Kampi/6502-Computer/project/Mainboard.kicad_pcb

## KiCad design project/Mainboard.kicad_pcb (2024-10-12)

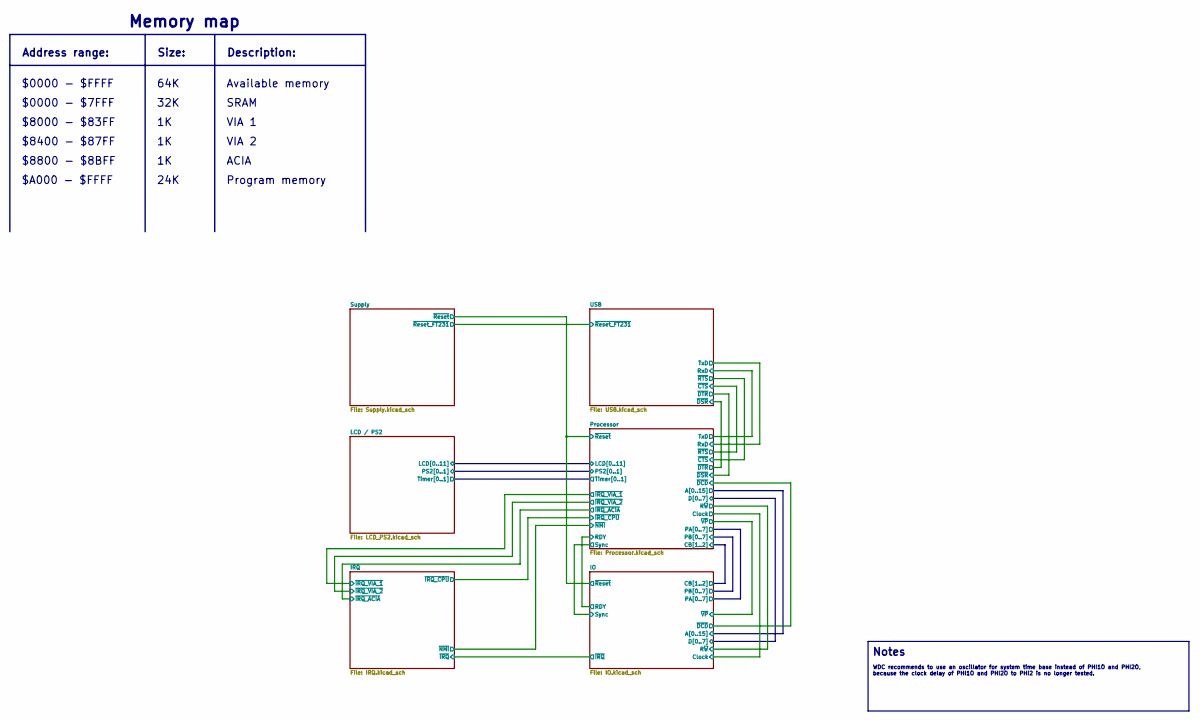
[picture p1: schematic Mainboard.kicad_sch]

Notes on the sheet:
$8000 - $83FF
Notes
$8400 - $87FF
64K
32K
ACIA
WDC recommends to use an oscillator for system time base instead of PHI1O and PHI2O, because the clock delay of PHI1O and PHI2O to PHI2 is no longer tested.
Size:
$8800 - $8BFF
Memory map
Program memory
Available memory
$0000 - $7FFF
SRAM
Address range:
24K
Description:
$0000 - $FFFF
$A000 - $FFFF
VIA 2
VIA 1

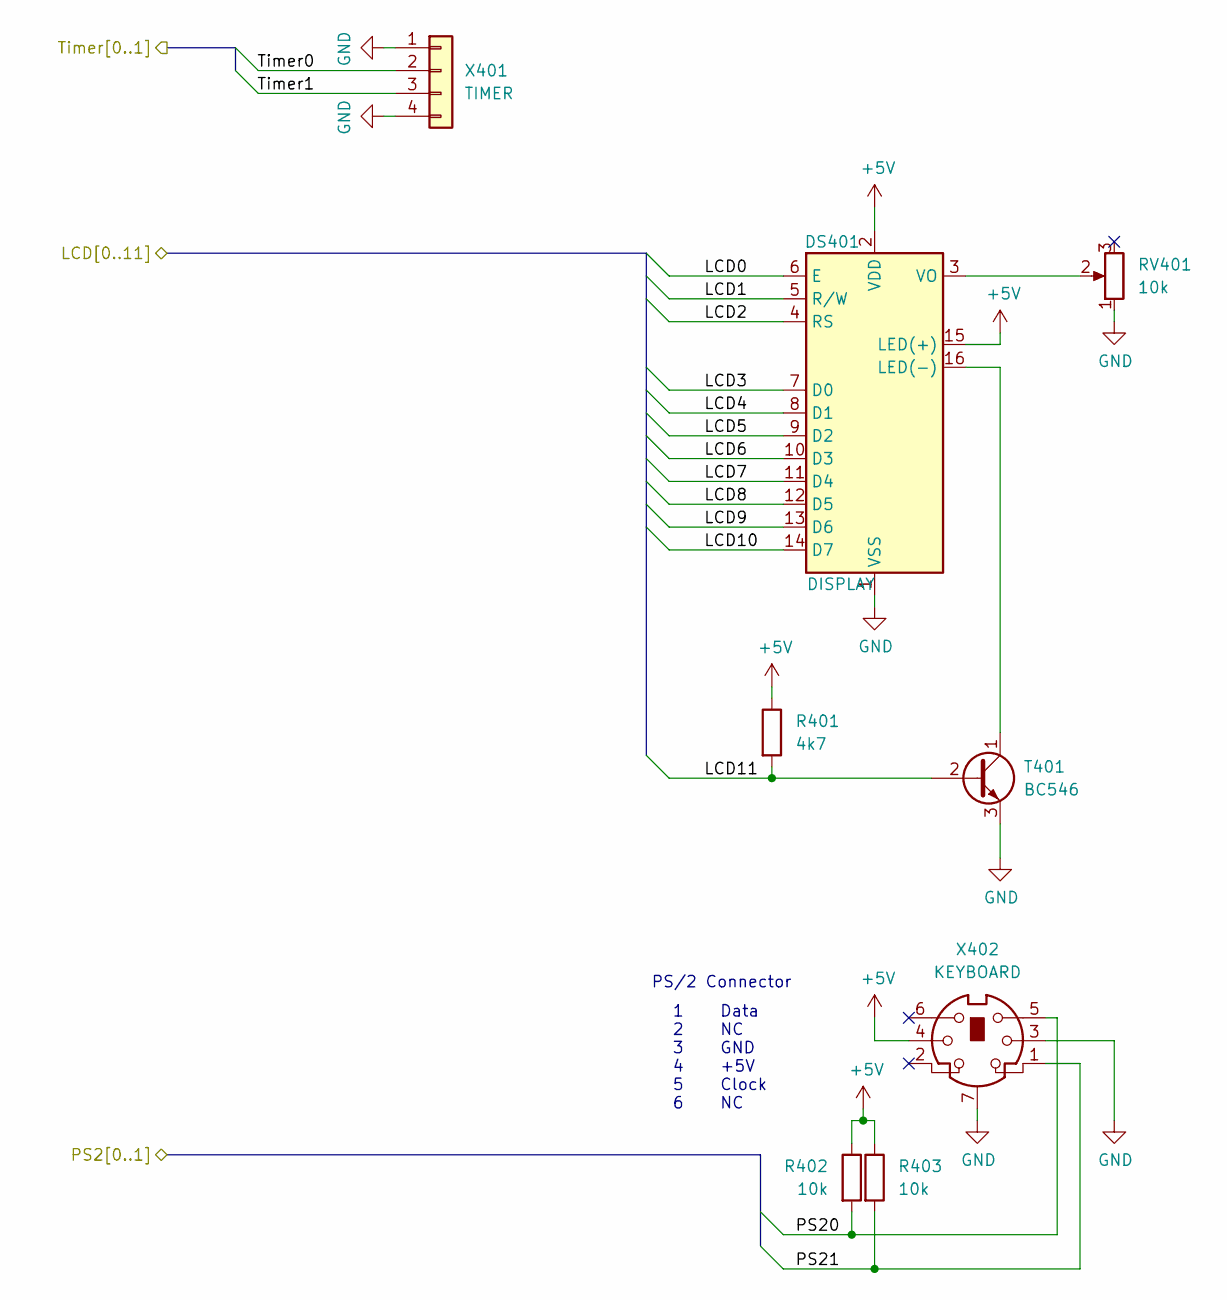
[picture p2: schematic LCD_PS2.kicad_sch, LCD, P2/2 & Timer]

Parts:
DS401: DISPLAY; WC1602A
R401: 4k7; R_Axial_DIN0207_L6.3mm_D2.5mm_P7.62mm_Horizontal
R402, R403: 10k; R_Axial_DIN0207_L6.3mm_D2.5mm_P7.62mm_Horizontal
RV401: 10k; Bourns_3386P_Vertical
T401: BC546; TO-92_Inline
X401: TIMER; PinHeader_1x04_P2.54mm_Vertical
X402: KEYBOARD; Mini-DIN_TE_Female_6Pin_2rows

Connections:
+5V: DS401.2 (VDD), DS401.15 (LED(+)), R401.1, R402.1, R403.1, X402.4; also elsewhere on the board
/LCD / PS2/LCD0: DS401.6 (E); also elsewhere on the board
/LCD / PS2/LCD1: DS401.5 (R/W); also elsewhere on the board
/LCD / PS2/LCD2: DS401.4 (RS); also elsewhere on the board
/LCD / PS2/LCD3: DS401.7 (D0); also elsewhere on the board
/LCD / PS2/LCD4: DS401.8 (D1); also elsewhere on the board
/LCD / PS2/LCD5: DS401.9 (D2); also elsewhere on the board
/LCD / PS2/LCD6: DS401.10 (D3); also elsewhere on the board
/LCD / PS2/LCD7: DS401.11 (D4); also elsewhere on the board
/LCD / PS2/LCD8: DS401.12 (D5); also elsewhere on the board
/LCD / PS2/LCD9: DS401.13 (D6); also elsewhere on the board
/LCD / PS2/LCD10: DS401.14 (D7); also elsewhere on the board
/LCD / PS2/LCD11: R401.2, T401.2 (B); also elsewhere on the board
/LCD / PS2/PS20: R402.2, X402.5; also elsewhere on the board
/LCD / PS2/PS21: R403.2, X402.1; also elsewhere on the board
/LCD / PS2/Timer0: X401.2; also elsewhere on the board
/LCD / PS2/Timer1: X401.3; also elsewhere on the board
GND: DS401.1 (VSS), RV401.1, T401.3 (E), X401.1, X401.4, X402.3, X402.7; also elsewhere on the board
unnamed: DS401.16 (LED(-)), T401.1 (C)
unnamed: DS401.3 (VO), RV401.2

Notes on the sheet:
PS/2 Connector
Data NC GND +5V Clock NC
1 2 3 4 5 6

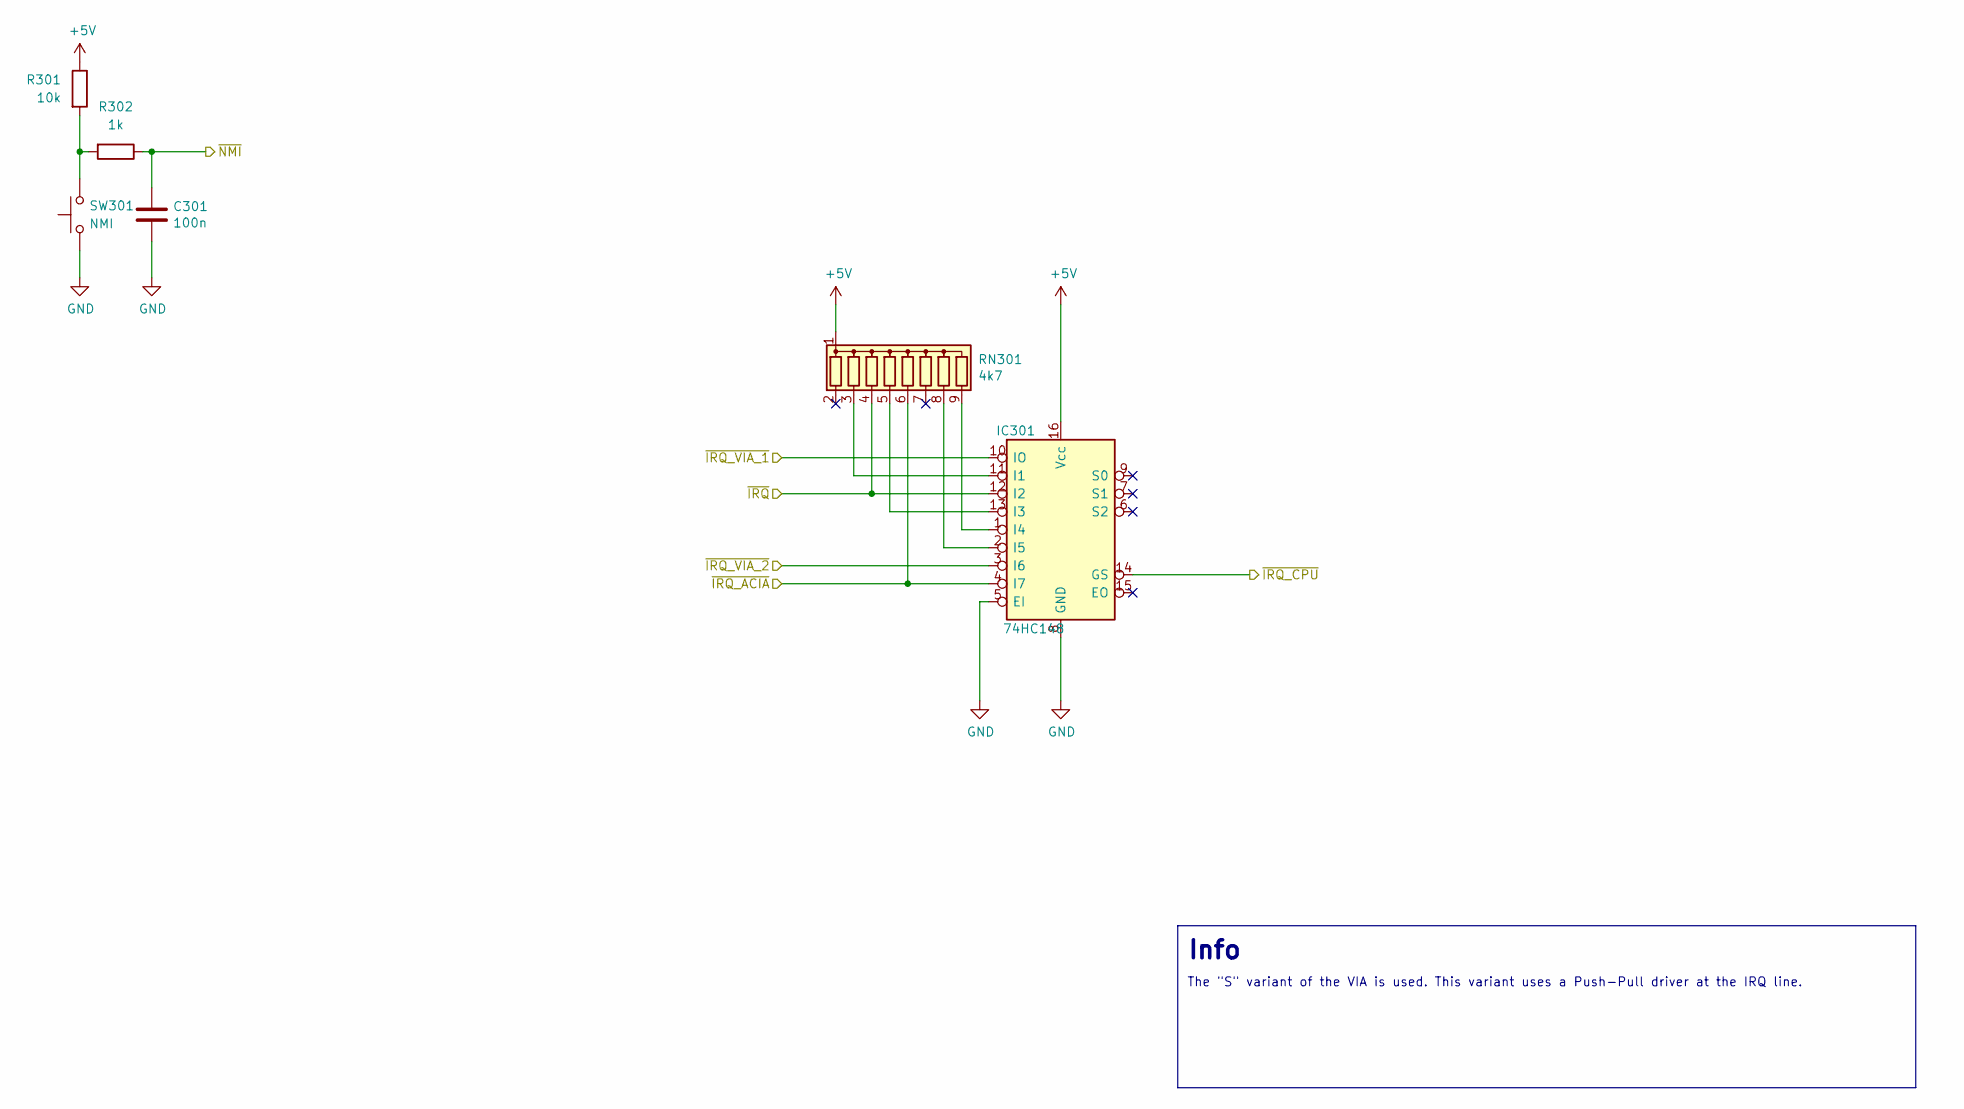
[picture p3: schematic IRQ.kicad_sch, Interrupt logic]

Parts:
C301: 100n; C_Rect_L4.0mm_W2.5mm_P2.50mm
IC301: 74HC148; DIP-16_W7.62mm_LongPads
R301: 10k; R_Axial_DIN0207_L6.3mm_D2.5mm_P7.62mm_Horizontal
R302: 1k; R_Axial_DIN0207_L6.3mm_D2.5mm_P7.62mm_Horizontal
RN301: 4k7; R_Array_SIP9
SW301: NMI; SW_PUSH_6mm_H4.3mm

Connections:
+5V: IC301.16 (Vcc), R301.1, RN301.1 (common); also elsewhere on the board
/IO/~IRQ: IC301.12 (I2), RN301.4 (R3); also elsewhere on the board
/IRQ/~IRQ_ACIA: IC301.4 (I7), RN301.6 (R5); also elsewhere on the board
/IRQ/~IRQ_CPU: IC301.14 (GS); also elsewhere on the board
/IRQ/~IRQ_VIA_1: IC301.10 (IO); also elsewhere on the board
/IRQ/~IRQ_VIA_2: IC301.3 (I6); also elsewhere on the board
/IRQ/~NMI: C301.1, R302.1; also elsewhere on the board
GND: C301.2, IC301.5 (EI), IC301.8 (GND), SW301.1; also elsewhere on the board
unnamed: IC301.11 (I1), RN301.3 (R2)
unnamed: IC301.13 (I3), RN301.5 (R4)
unnamed: IC301.1 (I4), RN301.9 (R8)
unnamed: IC301.2 (I5), RN301.8 (R7)
unnamed: R301.2, R302.2, SW301.2

Notes on the sheet:
Info
The "S" variant of the VIA is used. This variant uses a Push-Pull driver at the IRQ line.

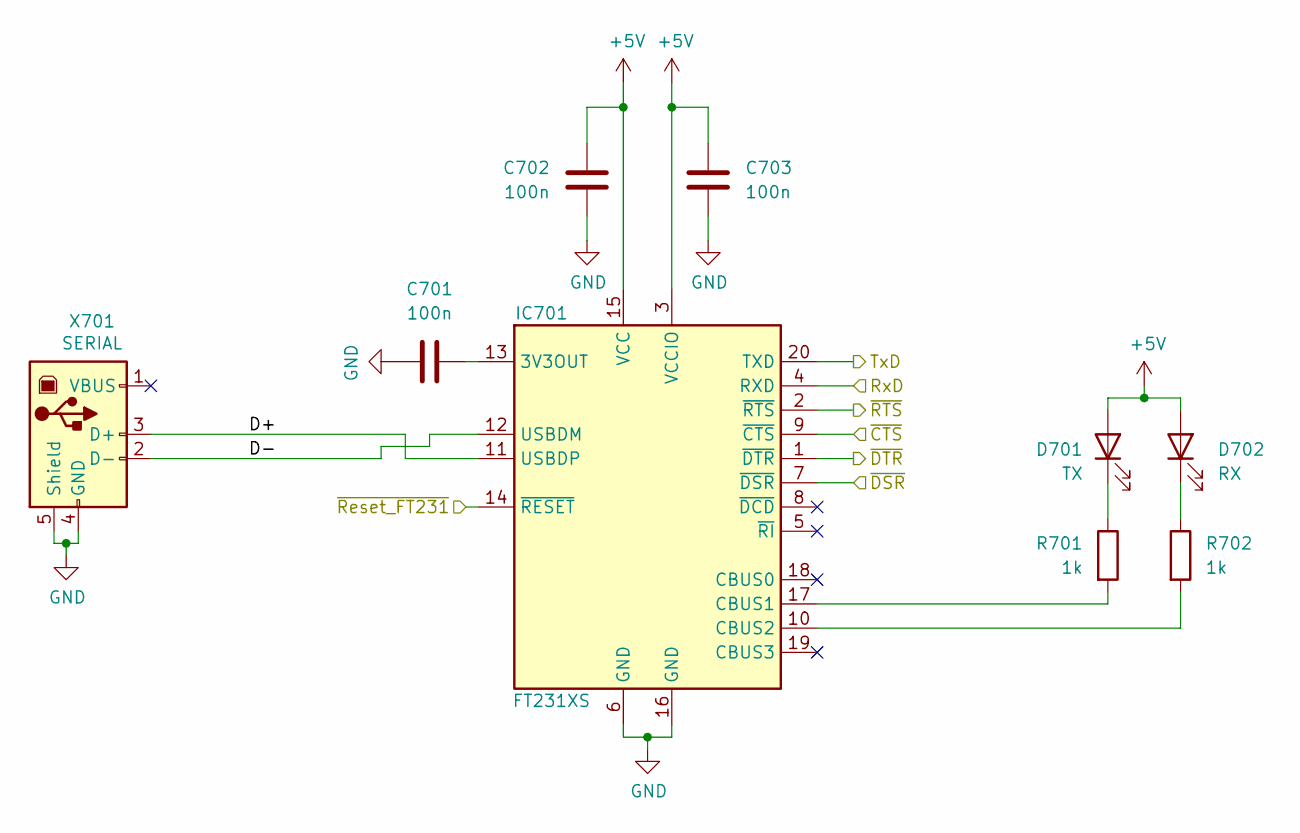
[picture p4: schematic USB.kicad_sch, USB-Serial]

Parts:
C701, C702, C703: 100n; C_0805_2012Metric
D701: TX; LED_0805_2012Metric
D702: RX; LED_0805_2012Metric
IC701: FT231XS; SSOP-20_3.9x8.7mm_P0.635mm
R701, R702: 1k; R_0805_2012Metric
X701: SERIAL; USB-B_TE_2923042_Horizontal

Connections:
+5V: C702.1, C703.1, D701.2 (A), D702.2 (A), IC701.3 (VCCIO), IC701.15 (VCC); also elsewhere on the board
/Processor/RxD: IC701.20 (TXD); also elsewhere on the board
/Processor/TxD: IC701.4 (RXD); also elsewhere on the board
/Processor/~CTS: IC701.2 (~RTS); also elsewhere on the board
/Processor/~DSR: IC701.1 (~DTR); also elsewhere on the board
/Processor/~DTR: IC701.7 (~DSR); also elsewhere on the board
/Processor/~RTS: IC701.9 (~CTS); also elsewhere on the board
/Supply/~Reset_FT231: IC701.14 (~RESET); also elsewhere on the board
/USB/D+: IC701.11 (USBDP), X701.3 (D+)
/USB/D-: IC701.12 (USBDM), X701.2 (D-)
GND: C701.1, C702.2, C703.2, IC701.6 (GND), IC701.16 (GND), X701.4 (GND), X701.5 (Shield); also elsewhere on the board
unnamed: D701.1 (K), R701.1
unnamed: D702.1 (K), R702.1
unnamed: C701.2, IC701.13 (3V3OUT)
unnamed: IC701.17 (CBUS1), R701.2
unnamed: IC701.10 (CBUS2), R702.2

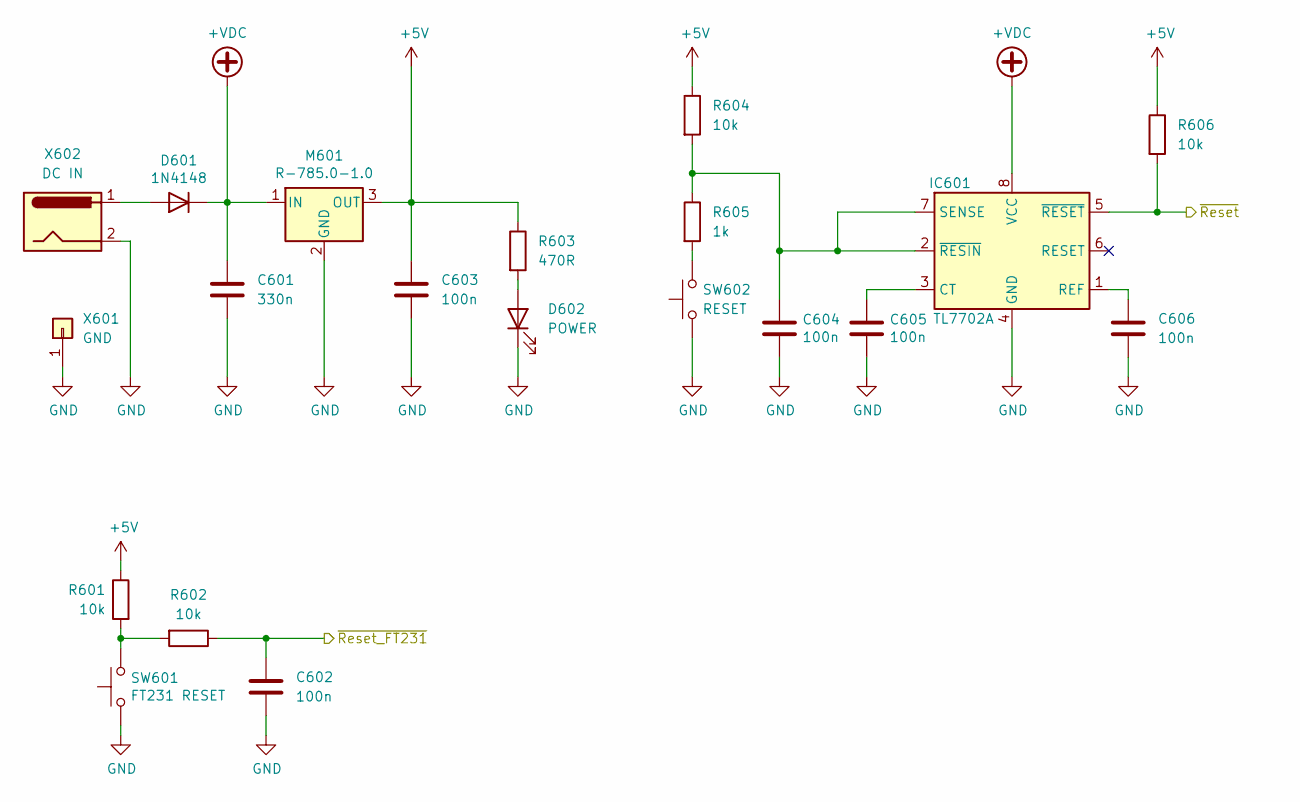
[picture p5: schematic Supply.kicad_sch, Power Supply & Reset]

Parts:
C601: 330n; C_Rect_L4.0mm_W2.5mm_P2.50mm
C602, C603, C604, C605, C606: 100n; C_Rect_L4.0mm_W2.5mm_P2.50mm
D601: 1N4148; D_SOD-123
D602: POWER; LED_D5.0mm
IC601: TL7702A; DIP-8_W7.62mm_LongPads
M601: R-785.0-1.0; Converter_DCDC_RECOM_R-78E-0.5_THT
R601, R602, R604, R606: 10k; R_Axial_DIN0207_L6.3mm_D2.5mm_P7.62mm_Horizontal
R603: 470R; R_Axial_DIN0207_L6.3mm_D2.5mm_P7.62mm_Horizontal
R605: 1k; R_Axial_DIN0207_L6.3mm_D2.5mm_P7.62mm_Horizontal
SW601: FT231 RESET; SW_PUSH_6mm_H4.3mm
SW602: RESET; SW_PUSH_6mm_H4.3mm
X601: GND; PinHeader_1x01_P2.54mm_Vertical
X602: DC IN; BarrelJack_Wuerth_6941xx301002

Connections:
+5V: C603.1, M601.3 (OUT), R601.1, R603.1, R604.1, R606.1; also elsewhere on the board
+VDC: C601.1, D601.1 (K), IC601.8 (VCC), M601.1 (IN)
/IO/~Reset: IC601.5 (~RESET), R606.2; also elsewhere on the board
/Supply/~Reset_FT231: C602.1, R602.1; also elsewhere on the board
GND: C601.2, C602.2, C603.2, C604.2, C605.2, C606.2, D602.1 (K), IC601.4 (GND), M601.2 (GND), SW601.1, SW602.1, X601.1, X602.2; also elsewhere on the board
unnamed: D601.2 (A), X602.1
unnamed: D602.2 (A), R603.2
unnamed: C605.1, IC601.3 (CT)
unnamed: C606.1, IC601.1 (REF)
unnamed: C604.1, IC601.2 (~RESIN), IC601.7 (SENSE), R604.2, R605.1
unnamed: R601.2, R602.2, SW601.2
unnamed: R605.2, SW602.2

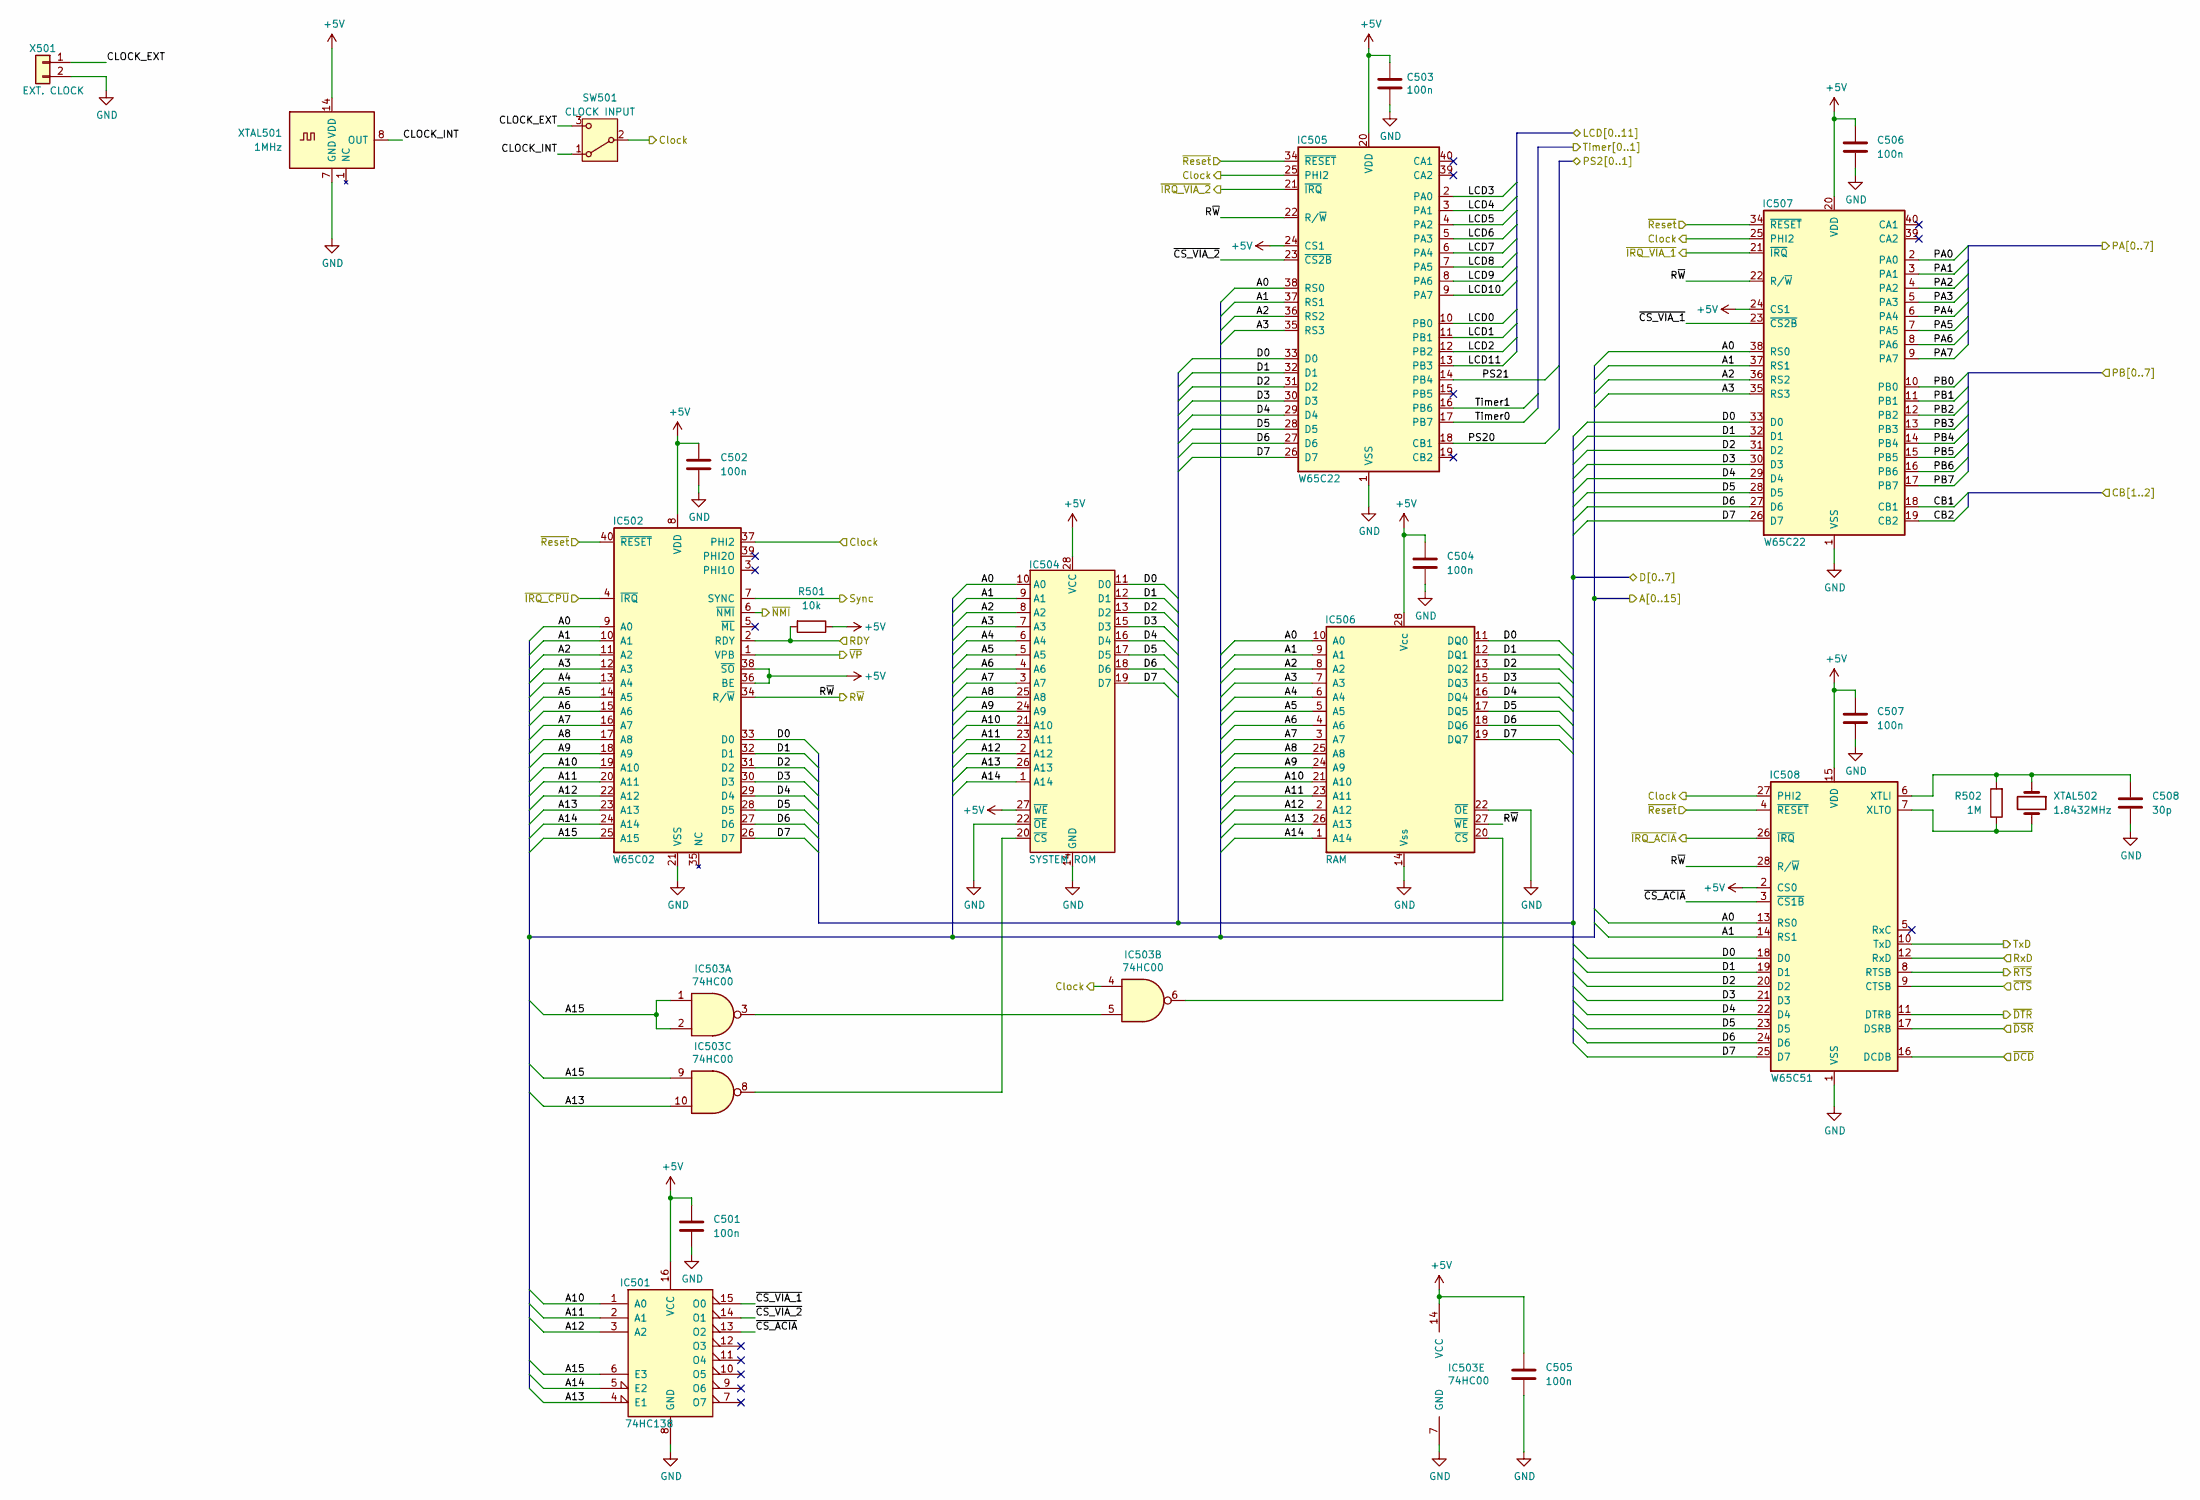
[picture p6: schematic Processor.kicad_sch, Processor system]

Parts:
C501, C502, C503, C504, C505, C506, C507: 100n; C_Rect_L4.0mm_W2.5mm_P2.50mm
C508: 30p; C_Rect_L4.0mm_W2.5mm_P2.50mm
IC501: 74HC138; DIP-16_W7.62mm_LongPads
IC502: W65C02; DIP-40_W15.24mm_LongPads
IC503: 74HC00; DIP-14_W7.62mm_LongPads
IC504: SYSTEM ROM; DIP-28_W15.24mm_LongPads
IC505, IC507: W65C22; DIP-40_W15.24mm_LongPads
IC506: RAM; DIP-28_W15.24mm_LongPads
IC508: W65C51; DIP-28_W15.24mm_LongPads
R501: 10k; R_Axial_DIN0207_L6.3mm_D2.5mm_P7.62mm_Horizontal
R502: 1M; R_Axial_DIN0207_L6.3mm_D2.5mm_P7.62mm_Horizontal
SW501: CLOCK INPUT; SW_E-Switch_EG1271_DPDT
X501: EXT. CLOCK; SMA_Amphenol_901-144_Vertical
XTAL501: 1MHz; Oscillator_DIP-14
XTAL502: 1.8432MHz; Crystal_HC49-U_Vertical

Connections:
+5V: C501.1, C502.1, C503.1, C504.1, C505.1, C506.1, C507.1, IC501.16 (VCC), IC502.8 (VDD), IC502.36 (BE), IC502.38 (~SO), IC503.14 (VCC), IC504.27 (~WE), IC504.28 (VCC), IC505.20 (VDD), IC505.24 (CS1), IC506.28 (Vcc), IC507.20 (VDD), IC507.24 (CS1), IC508.2 (CS0), IC508.15 (VDD), R501.1, XTAL501.14 (VDD); also elsewhere on the board
/IO/A0: IC502.9 (A0), IC504.10 (A0), IC505.38 (RS0), IC506.10 (A0), IC507.38 (RS0), IC508.13 (RS0); also elsewhere on the board
/IO/A1: IC502.10 (A1), IC504.9 (A1), IC505.37 (RS1), IC506.9 (A1), IC507.37 (RS1), IC508.14 (RS1); also elsewhere on the board
/IO/A2: IC502.11 (A2), IC504.8 (A2), IC505.36 (RS2), IC506.8 (A2), IC507.36 (RS2); also elsewhere on the board
/IO/A3: IC502.12 (A3), IC504.7 (A3), IC505.35 (RS3), IC506.7 (A3), IC507.35 (RS3); also elsewhere on the board
/IO/A4: IC502.13 (A4), IC504.6 (A4), IC506.6 (A4); also elsewhere on the board
/IO/A5: IC502.14 (A5), IC504.5 (A5), IC506.5 (A5); also elsewhere on the board
/IO/A6: IC502.15 (A6), IC504.4 (A6), IC506.4 (A6); also elsewhere on the board
/IO/A7: IC502.16 (A7), IC504.3 (A7), IC506.3 (A7); also elsewhere on the board
/IO/A8: IC502.17 (A8), IC504.25 (A8), IC506.25 (A8); also elsewhere on the board
/IO/A9: IC502.18 (A9), IC504.24 (A9), IC506.24 (A9); also elsewhere on the board
/IO/A10: IC501.1 (A0), IC502.19 (A10), IC504.21 (A10), IC506.21 (A10); also elsewhere on the board
/IO/A11: IC501.2 (A1), IC502.20 (A11), IC504.23 (A11), IC506.23 (A11); also elsewhere on the board
/IO/A12: IC501.3 (A2), IC502.22 (A12), IC504.2 (A12), IC506.2 (A12); also elsewhere on the board
/IO/A13: IC501.4 (E1), IC502.23 (A13), IC503.10, IC504.26 (A13), IC506.26 (A13); also elsewhere on the board
/IO/A14: IC501.5 (E2), IC502.24 (A14), IC504.1 (A14), IC506.1 (A14); also elsewhere on the board
/IO/A15: IC501.6 (E3), IC502.25 (A15), IC503.1, IC503.2, IC503.9; also elsewhere on the board
/IO/CB1: IC507.18 (CB1); also elsewhere on the board
/IO/CB2: IC507.19 (CB2); also elsewhere on the board
/IO/Clock: IC502.37 (PHI2), IC503.4, IC505.25 (PHI2), IC507.25 (PHI2), IC508.27 (PHI2), SW501.2 (B); also elsewhere on the board
/IO/D0: IC502.33 (D0), IC504.11 (D0), IC505.33 (D0), IC506.11 (DQ0), IC507.33 (D0), IC508.18 (D0); also elsewhere on the board
/IO/D1: IC502.32 (D1), IC504.12 (D1), IC505.32 (D1), IC506.12 (DQ1), IC507.32 (D1), IC508.19 (D1); also elsewhere on the board
/IO/D2: IC502.31 (D2), IC504.13 (D2), IC505.31 (D2), IC506.13 (DQ2), IC507.31 (D2), IC508.20 (D2); also elsewhere on the board
/IO/D3: IC502.30 (D3), IC504.15 (D3), IC505.30 (D3), IC506.15 (DQ3), IC507.30 (D3), IC508.21 (D3); also elsewhere on the board
/IO/D4: IC502.29 (D4), IC504.16 (D4), IC505.29 (D4), IC506.16 (DQ4), IC507.29 (D4), IC508.22 (D4); also elsewhere on the board
/IO/D5: IC502.28 (D5), IC504.17 (D5), IC505.28 (D5), IC506.17 (DQ5), IC507.28 (D5), IC508.23 (D5); also elsewhere on the board
/IO/D6: IC502.27 (D6), IC504.18 (D6), IC505.27 (D6), IC506.18 (DQ6), IC507.27 (D6), IC508.24 (D6); also elsewhere on the board
/IO/D7: IC502.26 (D7), IC504.19 (D7), IC505.26 (D7), IC506.19 (DQ7), IC507.26 (D7), IC508.25 (D7); also elsewhere on the board
/IO/PA0: IC507.2 (PA0); also elsewhere on the board
/IO/PA1: IC507.3 (PA1); also elsewhere on the board
/IO/PA2: IC507.4 (PA2); also elsewhere on the board
/IO/PA3: IC507.5 (PA3); also elsewhere on the board
/IO/PA4: IC507.6 (PA4); also elsewhere on the board
/IO/PA5: IC507.7 (PA5); also elsewhere on the board
/IO/PA6: IC507.8 (PA6); also elsewhere on the board
/IO/PA7: IC507.9 (PA7); also elsewhere on the board
/IO/PB0: IC507.10 (PB0); also elsewhere on the board
/IO/PB1: IC507.11 (PB1); also elsewhere on the board
/IO/PB2: IC507.12 (PB2); also elsewhere on the board
/IO/PB3: IC507.13 (PB3); also elsewhere on the board
/IO/PB4: IC507.14 (PB4); also elsewhere on the board
/IO/PB5: IC507.15 (PB5); also elsewhere on the board
/IO/PB6: IC507.16 (PB6); also elsewhere on the board
/IO/PB7: IC507.17 (PB7); also elsewhere on the board
/IO/RDY: IC502.2 (RDY), R501.2; also elsewhere on the board
/IO/Sync: IC502.7 (SYNC); also elsewhere on the board
/IO/~DCD: IC508.16 (DCDB); also elsewhere on the board
/IO/~Reset: IC502.40 (~RESET), IC505.34 (~RESET), IC507.34 (~RESET), IC508.4 (~RESET); also elsewhere on the board
/IO/~VP: IC502.1 (VPB); also elsewhere on the board
/IRQ/~IRQ_ACIA: IC508.26 (~IRQ); also elsewhere on the board
/IRQ/~IRQ_CPU: IC502.4 (~IRQ); also elsewhere on the board
/IRQ/~IRQ_VIA_1: IC507.21 (~IRQ); also elsewhere on the board
/IRQ/~IRQ_VIA_2: IC505.21 (~IRQ); also elsewhere on the board
/IRQ/~NMI: IC502.6 (~NMI); also elsewhere on the board
/LCD / PS2/LCD0: IC505.10 (PB0); also elsewhere on the board
/LCD / PS2/LCD1: IC505.11 (PB1); also elsewhere on the board
/LCD / PS2/LCD2: IC505.12 (PB2); also elsewhere on the board
/LCD / PS2/LCD3: IC505.2 (PA0); also elsewhere on the board
/LCD / PS2/LCD4: IC505.3 (PA1); also elsewhere on the board
/LCD / PS2/LCD5: IC505.4 (PA2); also elsewhere on the board
/LCD / PS2/LCD6: IC505.5 (PA3); also elsewhere on the board
/LCD / PS2/LCD7: IC505.6 (PA4); also elsewhere on the board
/LCD / PS2/LCD8: IC505.7 (PA5); also elsewhere on the board
/LCD / PS2/LCD9: IC505.8 (PA6); also elsewhere on the board
/LCD / PS2/LCD10: IC505.9 (PA7); also elsewhere on the board
/LCD / PS2/LCD11: IC505.13 (PB3); also elsewhere on the board
/LCD / PS2/PS20: IC505.18 (CB1); also elsewhere on the board
/LCD / PS2/PS21: IC505.14 (PB4); also elsewhere on the board
/LCD / PS2/Timer0: IC505.17 (PB7); also elsewhere on the board
/LCD / PS2/Timer1: IC505.16 (PB6); also elsewhere on the board
/Processor/CLOCK_EXT: SW501.3 (C), X501.1
/Processor/CLOCK_INT: SW501.1 (A), XTAL501.8 (OUT)
/Processor/RxD: IC508.12 (RxD); also elsewhere on the board
/Processor/R~W: IC502.34 (R/~W), IC505.22 (R/~W), IC506.27 (~WE), IC507.22 (R/~W), IC508.28 (R/~W); also elsewhere on the board
/Processor/TxD: IC508.10 (TxD); also elsewhere on the board
/Processor/~CS_ACIA: IC501.13 (O2), IC508.3 (~CS1B)
/Processor/~CS_VIA_1: IC501.15 (O0), IC507.23 (~CS2B)
/Processor/~CS_VIA_2: IC501.14 (O1), IC505.23 (~CS2B)
/Processor/~CTS: IC508.9 (CTSB); also elsewhere on the board
/Processor/~DSR: IC508.17 (DSRB); also elsewhere on the board
/Processor/~DTR: IC508.11 (DTRB); also elsewhere on the board
/Processor/~RTS: IC508.8 (RTSB); also elsewhere on the board
GND: C501.2, C502.2, C503.2, C504.2, C505.2, C506.2, C507.2, C508.2, IC501.8 (GND), IC502.21 (VSS), IC503.7 (GND), IC504.14 (GND), IC504.22 (~OE), IC505.1 (VSS), IC506.14 (Vss), IC506.22 (~OE), IC507.1 (VSS), IC508.1 (VSS), X501.2, XTAL501.7 (GND); also elsewhere on the board
unnamed: IC503.3, IC503.5
unnamed: IC503.8, IC504.20 (~CS)
unnamed: IC503.6, IC506.20 (~CS)
unnamed: IC508.7 (XLTO), R502.1, XTAL502.2
unnamed: C508.1, IC508.6 (XTLI), R502.2, XTAL502.1

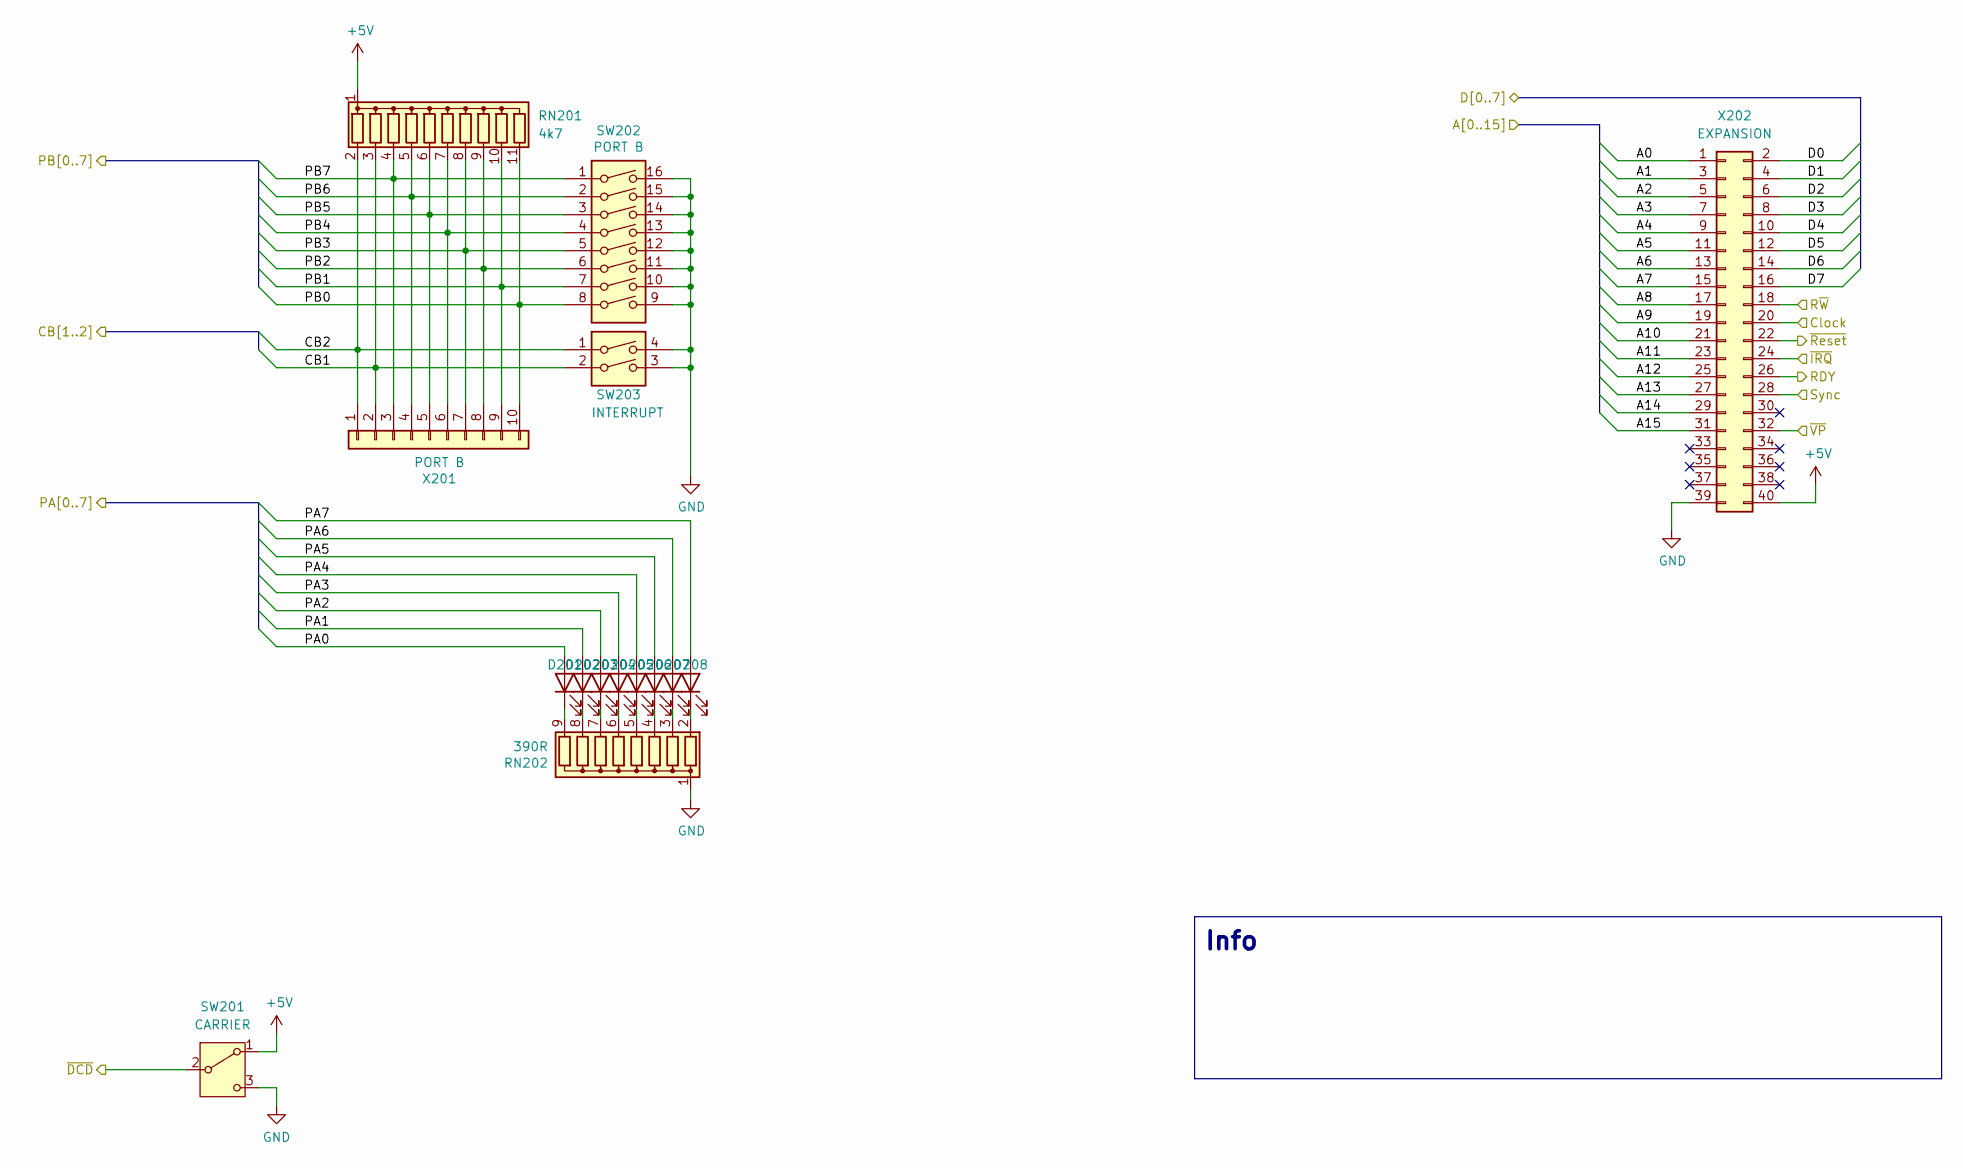
[picture p7: schematic IO.kicad_sch, I/O]

Parts:
D201: LED0; LED_D5.0mm
D202: LED1; LED_D5.0mm
D203: LED2; LED_D5.0mm
D204: LED3; LED_D5.0mm
D205: LED4; LED_D5.0mm
D206: LED5; LED_D5.0mm
D207: LED6; LED_D5.0mm
D208: LED7; LED_D5.0mm
RN201: 4k7; R_Array_SIP11
RN202: 390R; R_Array_SIP9
SW201: CARRIER; SW_E-Switch_EG1224_SPDT_Angled
SW202: PORT B; SW_DIP_SPSTx08_Slide_9.78x22.5mm_W7.62mm_P2.54mm
SW203: INTERRUPT; SW_DIP_SPSTx02_Slide_9.78x7.26mm_W7.62mm_P2.54mm
X201: PORT B; PinHeader_1x10_P2.54mm_Vertical
X202: EXPANSION; PinHeader_2x20_P2.54mm_Horizontal

Connections:
+5V: RN201.1 (common), SW201.1 (A), X202.40; also elsewhere on the board
/IO/A0: X202.1; also elsewhere on the board
/IO/A1: X202.3; also elsewhere on the board
/IO/A2: X202.5; also elsewhere on the board
/IO/A3: X202.7; also elsewhere on the board
/IO/A4: X202.9; also elsewhere on the board
/IO/A5: X202.11; also elsewhere on the board
/IO/A6: X202.13; also elsewhere on the board
/IO/A7: X202.15; also elsewhere on the board
/IO/A8: X202.17; also elsewhere on the board
/IO/A9: X202.19; also elsewhere on the board
/IO/A10: X202.21; also elsewhere on the board
/IO/A11: X202.23; also elsewhere on the board
/IO/A12: X202.25; also elsewhere on the board
/IO/A13: X202.27; also elsewhere on the board
/IO/A14: X202.29; also elsewhere on the board
/IO/A15: X202.31; also elsewhere on the board
/IO/CB1: RN201.3 (R2), SW203.2, X201.2; also elsewhere on the board
/IO/CB2: RN201.2 (R1), SW203.1, X201.1; also elsewhere on the board
/IO/Clock: X202.20; also elsewhere on the board
/IO/D0: X202.2; also elsewhere on the board
/IO/D1: X202.4; also elsewhere on the board
/IO/D2: X202.6; also elsewhere on the board
/IO/D3: X202.8; also elsewhere on the board
/IO/D4: X202.10; also elsewhere on the board
/IO/D5: X202.12; also elsewhere on the board
/IO/D6: X202.14; also elsewhere on the board
/IO/D7: X202.16; also elsewhere on the board
/IO/PA0: D201.2 (A); also elsewhere on the board
/IO/PA1: D202.2 (A); also elsewhere on the board
/IO/PA2: D203.2 (A); also elsewhere on the board
/IO/PA3: D204.2 (A); also elsewhere on the board
/IO/PA4: D205.2 (A); also elsewhere on the board
/IO/PA5: D206.2 (A); also elsewhere on the board
/IO/PA6: D207.2 (A); also elsewhere on the board
/IO/PA7: D208.2 (A); also elsewhere on the board
/IO/PB0: RN201.11 (R10), SW202.8, X201.10; also elsewhere on the board
/IO/PB1: RN201.10 (R9), SW202.7, X201.9; also elsewhere on the board
/IO/PB2: RN201.9 (R8), SW202.6, X201.8; also elsewhere on the board
/IO/PB3: RN201.8 (R7), SW202.5, X201.7; also elsewhere on the board
/IO/PB4: RN201.7 (R6), SW202.4, X201.6; also elsewhere on the board
/IO/PB5: RN201.6 (R5), SW202.3, X201.5; also elsewhere on the board
/IO/PB6: RN201.5 (R4), SW202.2, X201.4; also elsewhere on the board
/IO/PB7: RN201.4 (R3), SW202.1, X201.3; also elsewhere on the board
/IO/RDY: X202.26; also elsewhere on the board
/IO/Sync: X202.28; also elsewhere on the board
/IO/~DCD: SW201.2 (B); also elsewhere on the board
/IO/~IRQ: X202.24; also elsewhere on the board
/IO/~Reset: X202.22; also elsewhere on the board
/IO/~VP: X202.32; also elsewhere on the board
/Processor/R~W: X202.18; also elsewhere on the board
GND: RN202.1 (common), SW201.3 (C), SW202.9, SW202.10, SW202.11, SW202.12, SW202.13, SW202.14, SW202.15, SW202.16, SW203.3, SW203.4, X202.39; also elsewhere on the board
unnamed: D201.1 (K), RN202.9 (R8)
unnamed: D202.1 (K), RN202.8 (R7)
unnamed: D203.1 (K), RN202.7 (R6)
unnamed: D204.1 (K), RN202.6 (R5)
unnamed: D205.1 (K), RN202.5 (R4)
unnamed: D206.1 (K), RN202.4 (R3)
unnamed: D207.1 (K), RN202.3 (R2)
unnamed: D208.1 (K), RN202.2 (R1)

Notes on the sheet:
Info
