Kampi/6502-Computer/project/Mainboard.kicad_pcb

## KiCad design project/Mainboard.kicad_pcb (continued)

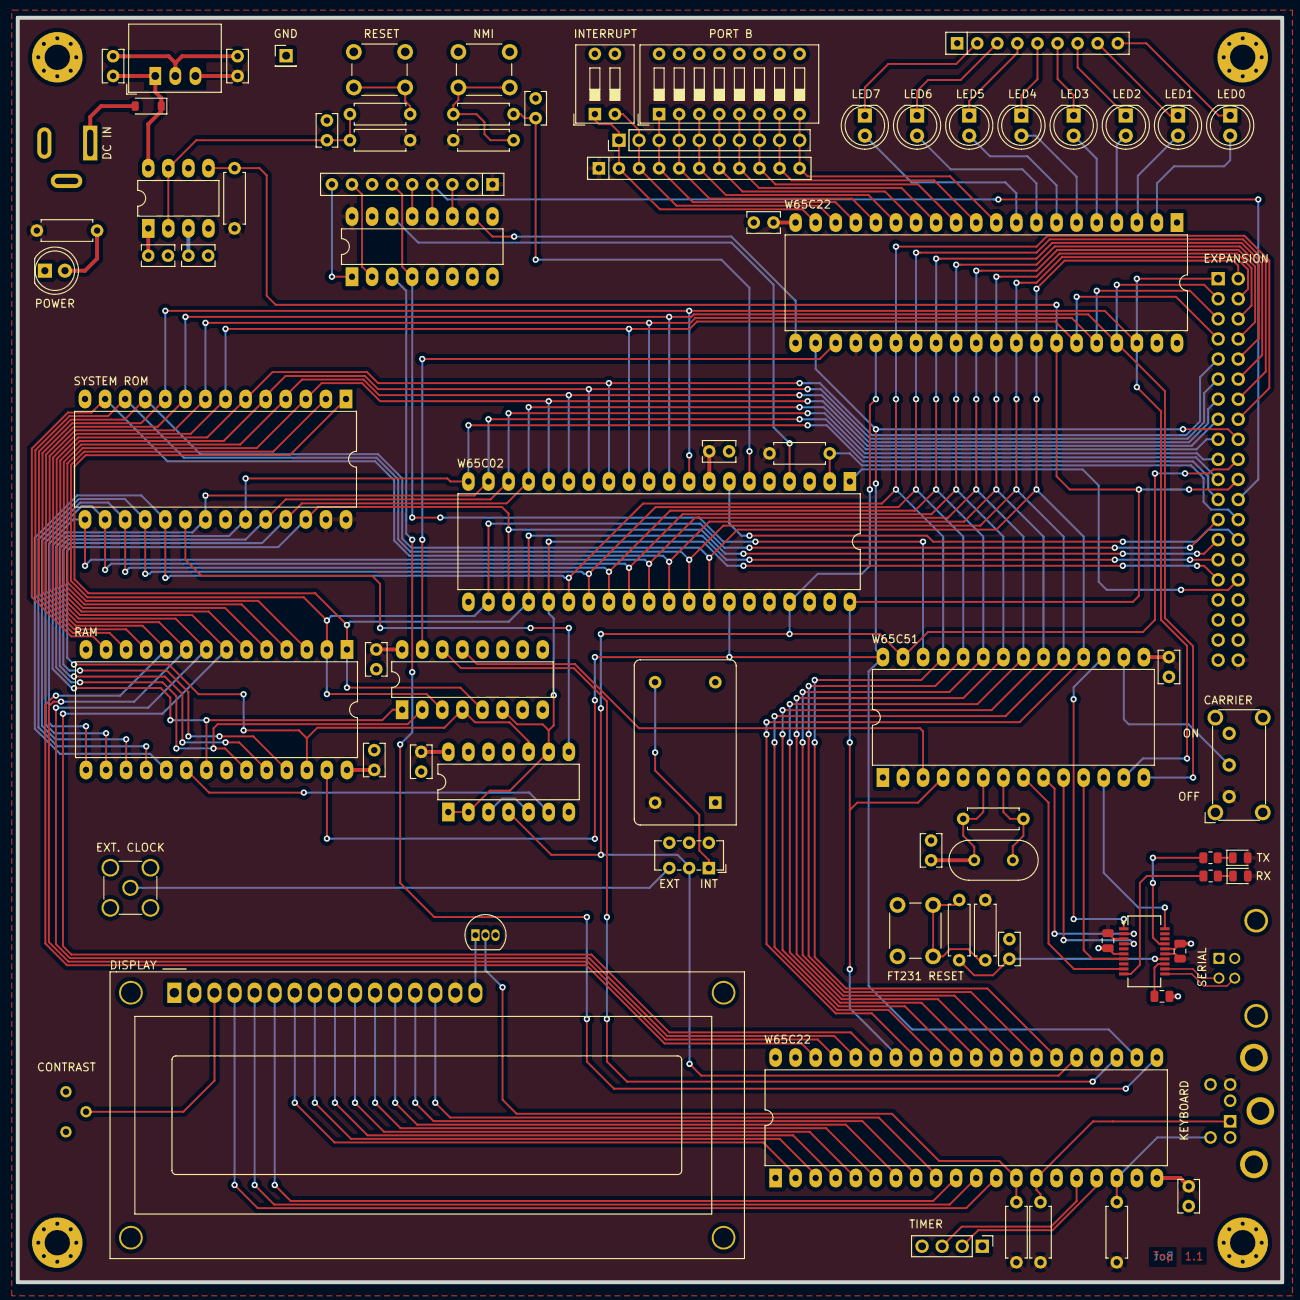
[picture p8: board Mainboard.kicad_pcb from above]

Board: 2 copper layers, 160.0 x 160.0 mm, 80 parts (0 on the bottom side), 120 nets.
