Kampi/6502-Computer/(commit log)

2024-10-12 Fix grid issues, fix missing libraries, replace FT232 with FT231
    [IO.kicad_sch, IRQ.kicad_sch, LCD_PS2.kicad_sch, Mainboard.kicad_pcb, Mainboard.kicad_sch, Processor.kicad_sch, Supply.kicad_sch, USB.kicad_sch]
2024-10-12 Fix swapped DM and DP, add missing datasheets, remove Mouser property
    [IO.kicad_sch, IRQ.kicad_sch, LCD_PS2.kicad_sch, Mainboard.kicad_pcb, Processor.kicad_sch, Supply.kicad_sch, USB.kicad_sch]
